IoTMakers/galena_lite_gateway_esp32/README.md

# Galena Lite Gateway

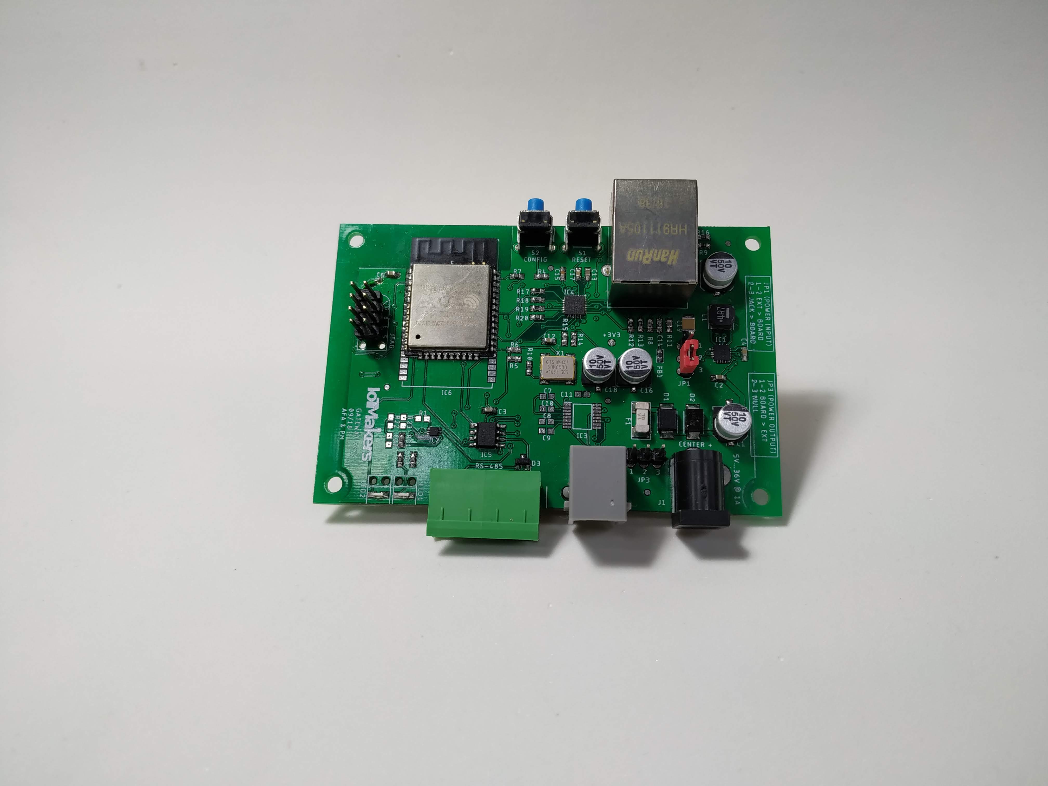
[picture p1: IMG_20190402_181117.jpg]
Galena Board


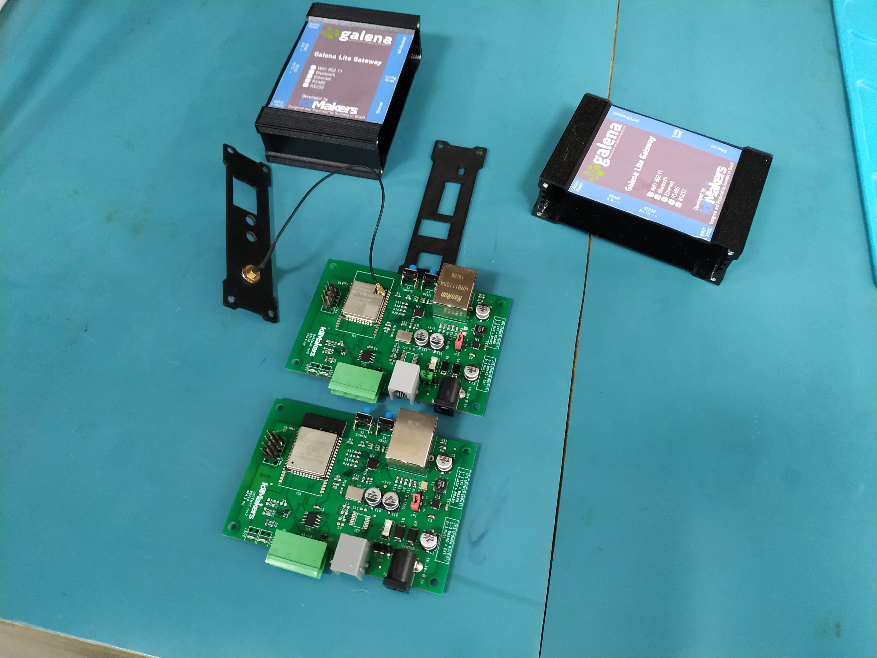
[picture p2: IMG_20190411_090804.jpg]
Galena Board 2
