IoTMakers/galena_lite_gateway_esp32/Gateway2.ods

Part | Value | PN | Package | Description
C1 | 47uFX63V | CPOL-EUUD-6,3X7,7 | UD-6,3X7,7_NICHICON | POLARIZED CAPACITOR, European symbol
C5 | 47uFX16V | CPOL-EUUD-6,3X7,7 | UD-6,3X7,7_NICHICON | POLARIZED CAPACITOR, European symbol
C2,C3,C4,C6,C7,C8,C9,C10,C11,C12,C13,C14,C17,C20 | 100nFX50V | 1.5PF-0603-50V-16.667% | 603 | 1.5pF ceramic capacitors
C15 | 10nFX50V | 1.5PF-0603-50V-16.667% | 603 | 1.5pF ceramic capacitors
C16 | 4,7uFX16V | CPOL-EUUD-6,3X7,7 | UD-6,3X7,7_NICHICON | POLARIZED CAPACITOR, European symbol
C18 | 22uFX16V | CPOL-EUUD-6,3X7,7 | UD-6,3X7,7_NICHICON | POLARIZED CAPACITOR, European symbol
C19 | 1nFx2KV | CAP1206 | 1206 | Capacitor
D1 | NRVTSS5100ET3G | DIODE-SMB | SMB | Trench Schottky Rectifier, Very Low Leakage, 100V, 5A, | https://octopart.com/nrvtss5100et3g-on+semiconductor-54318003?r=sp&s=3RSZuAp-RM25aGkVLBypew | 295 | 160 | 120
D2 | SMBJ18A | DIODE-SMB | SMB | Transient Voltage Suppressor, Tvs, Smbj Series, Unidirectional, 18 V, Do-214Aa, 2, 20 V | https://octopart.com/smbj18a-littelfuse-35303?r=sp&s=4dYVqdaxRqaxTtnNDyuJrg | 390 | 264 | 159
D3 | SM712 | CDSOT23-SM712 | SOT-23-3 | SM Series 12 V 400 W Asymmetrical TVS Diode for Extended Common-Mode - SOT-23 | https://octopart.com/sm712.tct-semtech-349737?r=sp&s=lC-qxbO_SEW0H2wgcGuGEQ | 1.47 | 1.17 | 828
F1 | FUSE_0679L | FUSE_0679L | FUSE_0679L
FB1 | KMZ1608 | SMD-FERRITE-BEAD-120R-2A(0603) | L0603 | Ferrite Beads Chip 120Ohm 25% 100MHz 500mA 150mOhm DCR 0603 Automotive T/R | https://octopart.com/kmz1608shr121atd25-tdk-81879006?r=sp&s=i-8ejY1UTXWYH8mM6MWRfQ | 86 | 78 | 58
IC1 | TS30041-M033QFNR | TS30041-M | QFN50P300X300X100-17N
IC2 | MIC826TYMT-TR | MIC826RYMT | DFN-6
IC3 | ICL3221EIVZ | ICL3221EIVZ | SOP65P640X120-16N | Intersil ICL3221EIVZ, Line Transceiver, EIA/TIA-232/ RS-232/ V.24/ V.28, 3.3 V, 5 V, 16-Pin TSSOP
IC4 | LAN8720A-CP-ABC | LAN8720A-CP-ABC | QFN50P400X400X100-25N | Small Footprint RMII 10/100 Ethernet Transceiver with flexPWR Technology | https://octopart.com/lan8720a-cp-abc-microchip-75448787?r=sp&s=7byqCG0IQSSVu6jzinN7dw | 1.03 | 837 | 837
IC5 | ISL83485 | ISL83485 | SOIC127P600X175-8N | ISL83485 Series 3.6 V 10 Mbps Surface Mount RS-485/RS-422 Transceiver - SOIC-8 | https://octopart.com/isl83485ibz-renesas-88255736?r=sp&s=jnq9nzpCSROeZyEJ8LCHPg | 1.25 | 1000 | 725
IC6 | ESP-WROOM-32 | ESP-WROOM-32 | ESP-WROOM-32 | Wifi Module 64 Mbits Spi Flash | https://octopart.com/esp-wroom-32+%288mb%29-espressif+systems-92180086?r=sp&s=xx4P1WQtRkG8gaGtFb6uUA | 4.20 | 4.20 | 4.20
J1 | POWER_JACK | POWER_JACK | POWER_JACK_PTH
J2 | RJ45-HR911105A-HR911105A | RJ45-HR911105A-HR911105A | RJ45
J3 | a | 1757268 | SHDR4W120P0X508_1X4_2224X1200X | Pluggable Terminal Blocks 4 Pos 5.08mm pitch Through Hole Header
JP1 |  | PINHD-1X3 | 1X03 | PIN HEADER
JP3 |  | PINHD-1X3 | 1X03 | PIN HEADER
K1 | RJ9 | 615004143821 | 615004143821 | WR-MJ Horizontal Plastic 4P4C Modular Jack Tab Up, 4 Pins=>Code : Con_I-O_MJ-H_Plastic_Up_615004143821
L1 | 4.7uH 2A | NRS5020T220MMGJ | INDM4949X200N | Inductor Power Shielded Wirewound 22uH 20% 100KHz Ferrite 1A 312mOhm DCR T/R
LED1,LED2 |  | LTST-S220GKT | LTST-S220KFKT | Lite-On LTST-S220GKT Green LED, 569 nm, 2012 (0805) Side View, Rectangle Lens SMD Package
R1,R6,R8,R11,R12,R13 | 49R9 | 0.27OHM-0603-1/10W-1% | 603 | 0.27Ω resistor
R2,R4,R5,R10,R15,R21,R22,R23 | 10K | 0.27OHM-0603-1/10W-1% | 603 | 0.27Ω resistor
R3,R7,R9,R16 | 330R | 0.27OHM-0603-1/10W-1% | 603 | 0.27Ω resistor
R14 | 12K1 | 0.27OHM-0603-1/10W-1% | 603 | 0.27Ω resistor
R17,R18,R19,R20 | 4K7 | 0.27OHM-0603-1/10W-1% | 603 | 0.27Ω resistor
S1,S2 | RESET | MOMENTARY-SWITCH-SPST-PTH-RIGHT-ANGLE-KIT | TACTILE_SWITCH_PTH_RIGHT_ANGLE_KIT | Momentary Switch (Pushbutton) - SPST
X1 |  | KXO-TCXO-CMOS-82 | 7.0X5.0_KXO-82-TCXO | TCXO :
