IoTMakers/galena_lite_gateway_esp32/Galena_Gateway.pdf

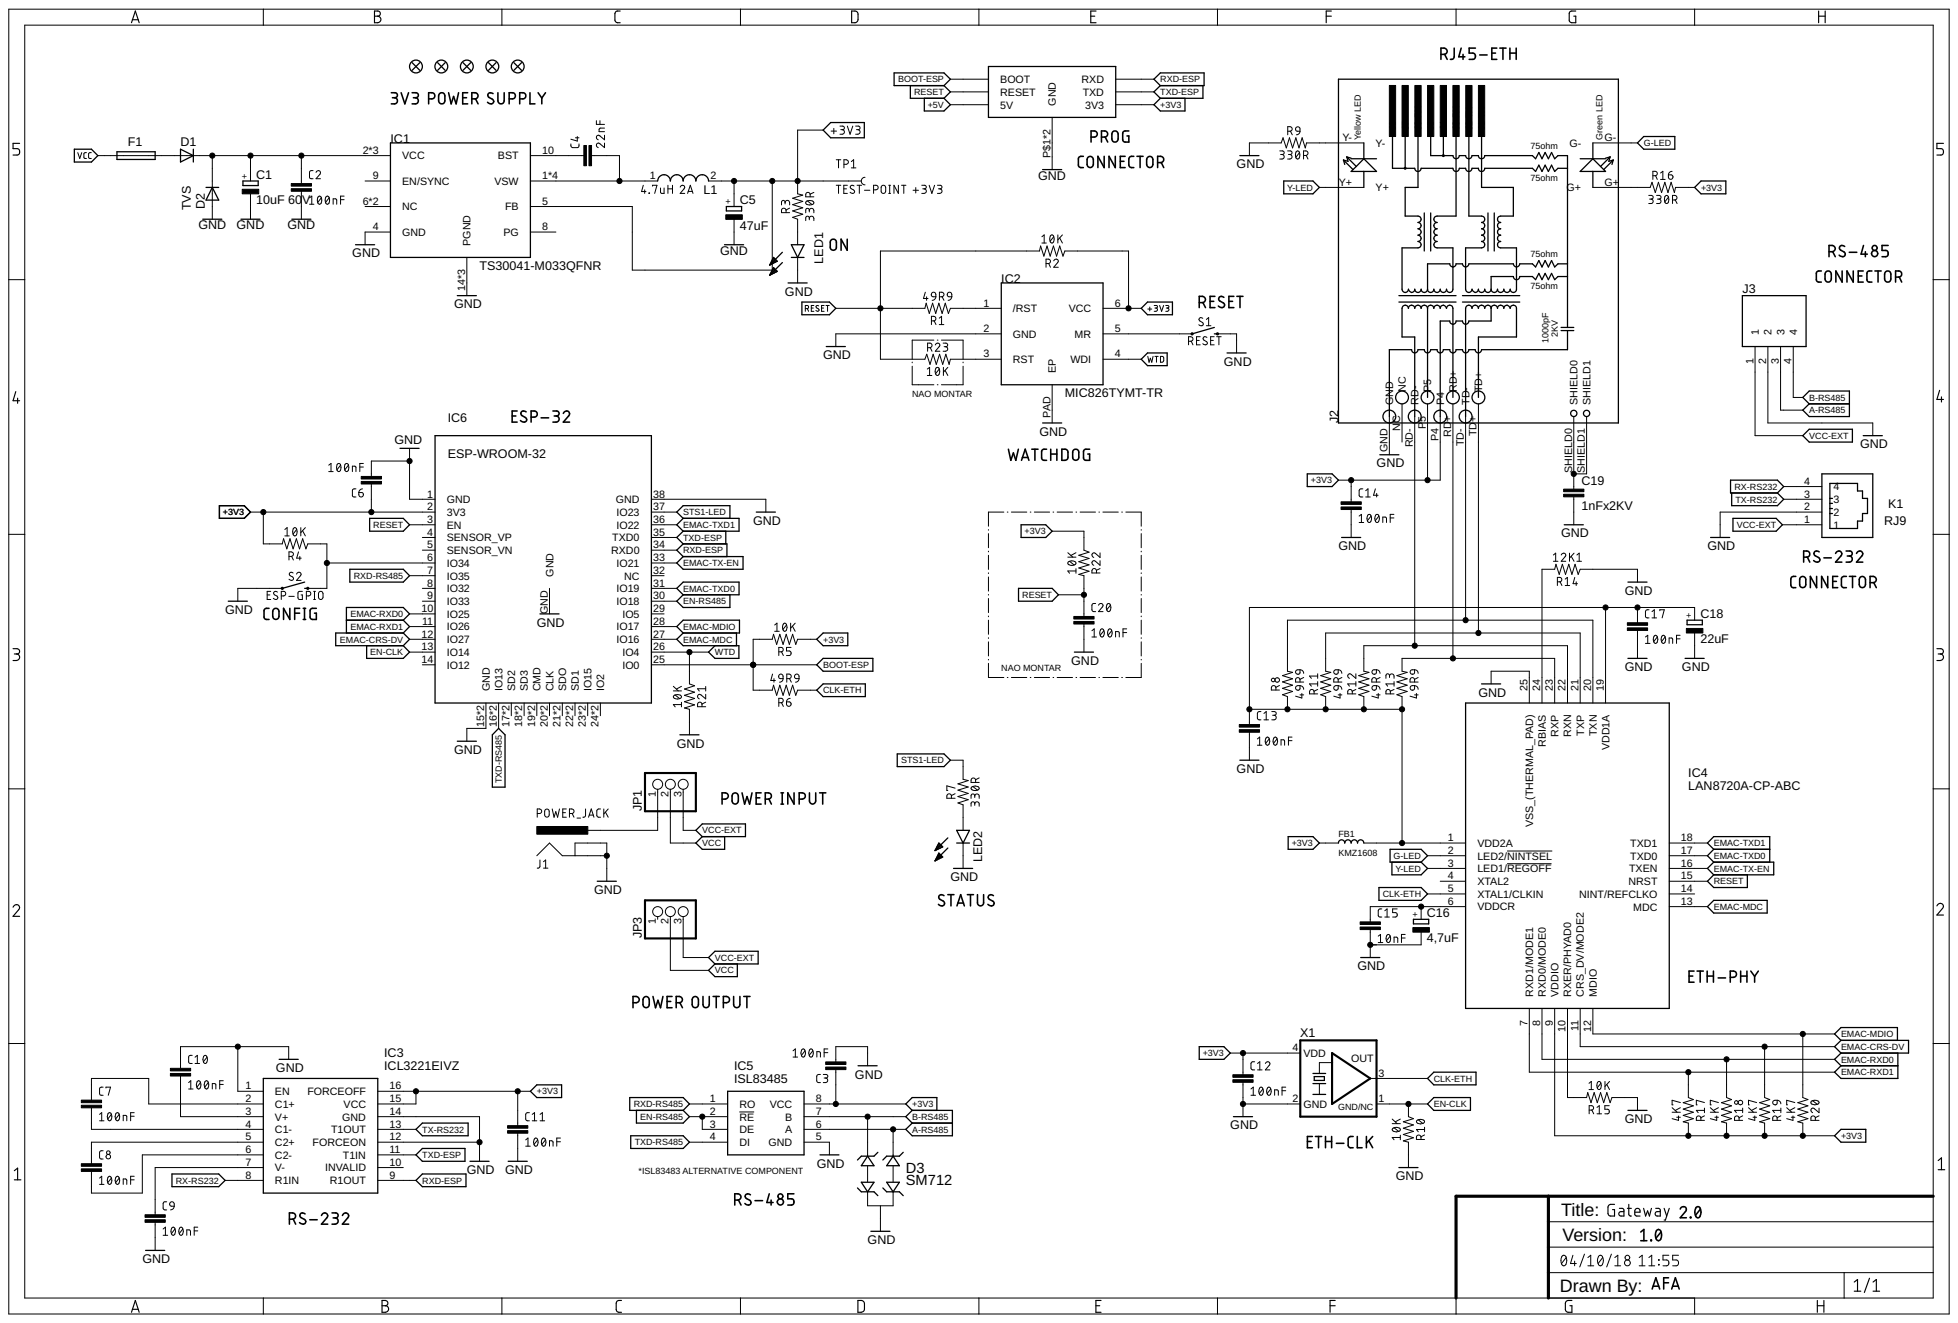
[picture p3: page 1]

J2 TX- J1 TX+ TD+ TD+ TD- TD- P4 P4 RD- RD- GND GND

7 | EMAC-TX-EN

11 EMAC-RXD1 | GND | 28 EMAC-MDIO

G-LED | LED2/NINTSEL | EMAC-TXD0 16 NRST
Y-LED | LED1/REGOFF | 15 NINT/REFCLKO EMAC-TX-EN RESET

Drawn By: Title: Version:
