IoTMakers/galena_lite_gateway_esp32/Gateway.brd

## EAGLE design Gateway.brd (2020-08-04)

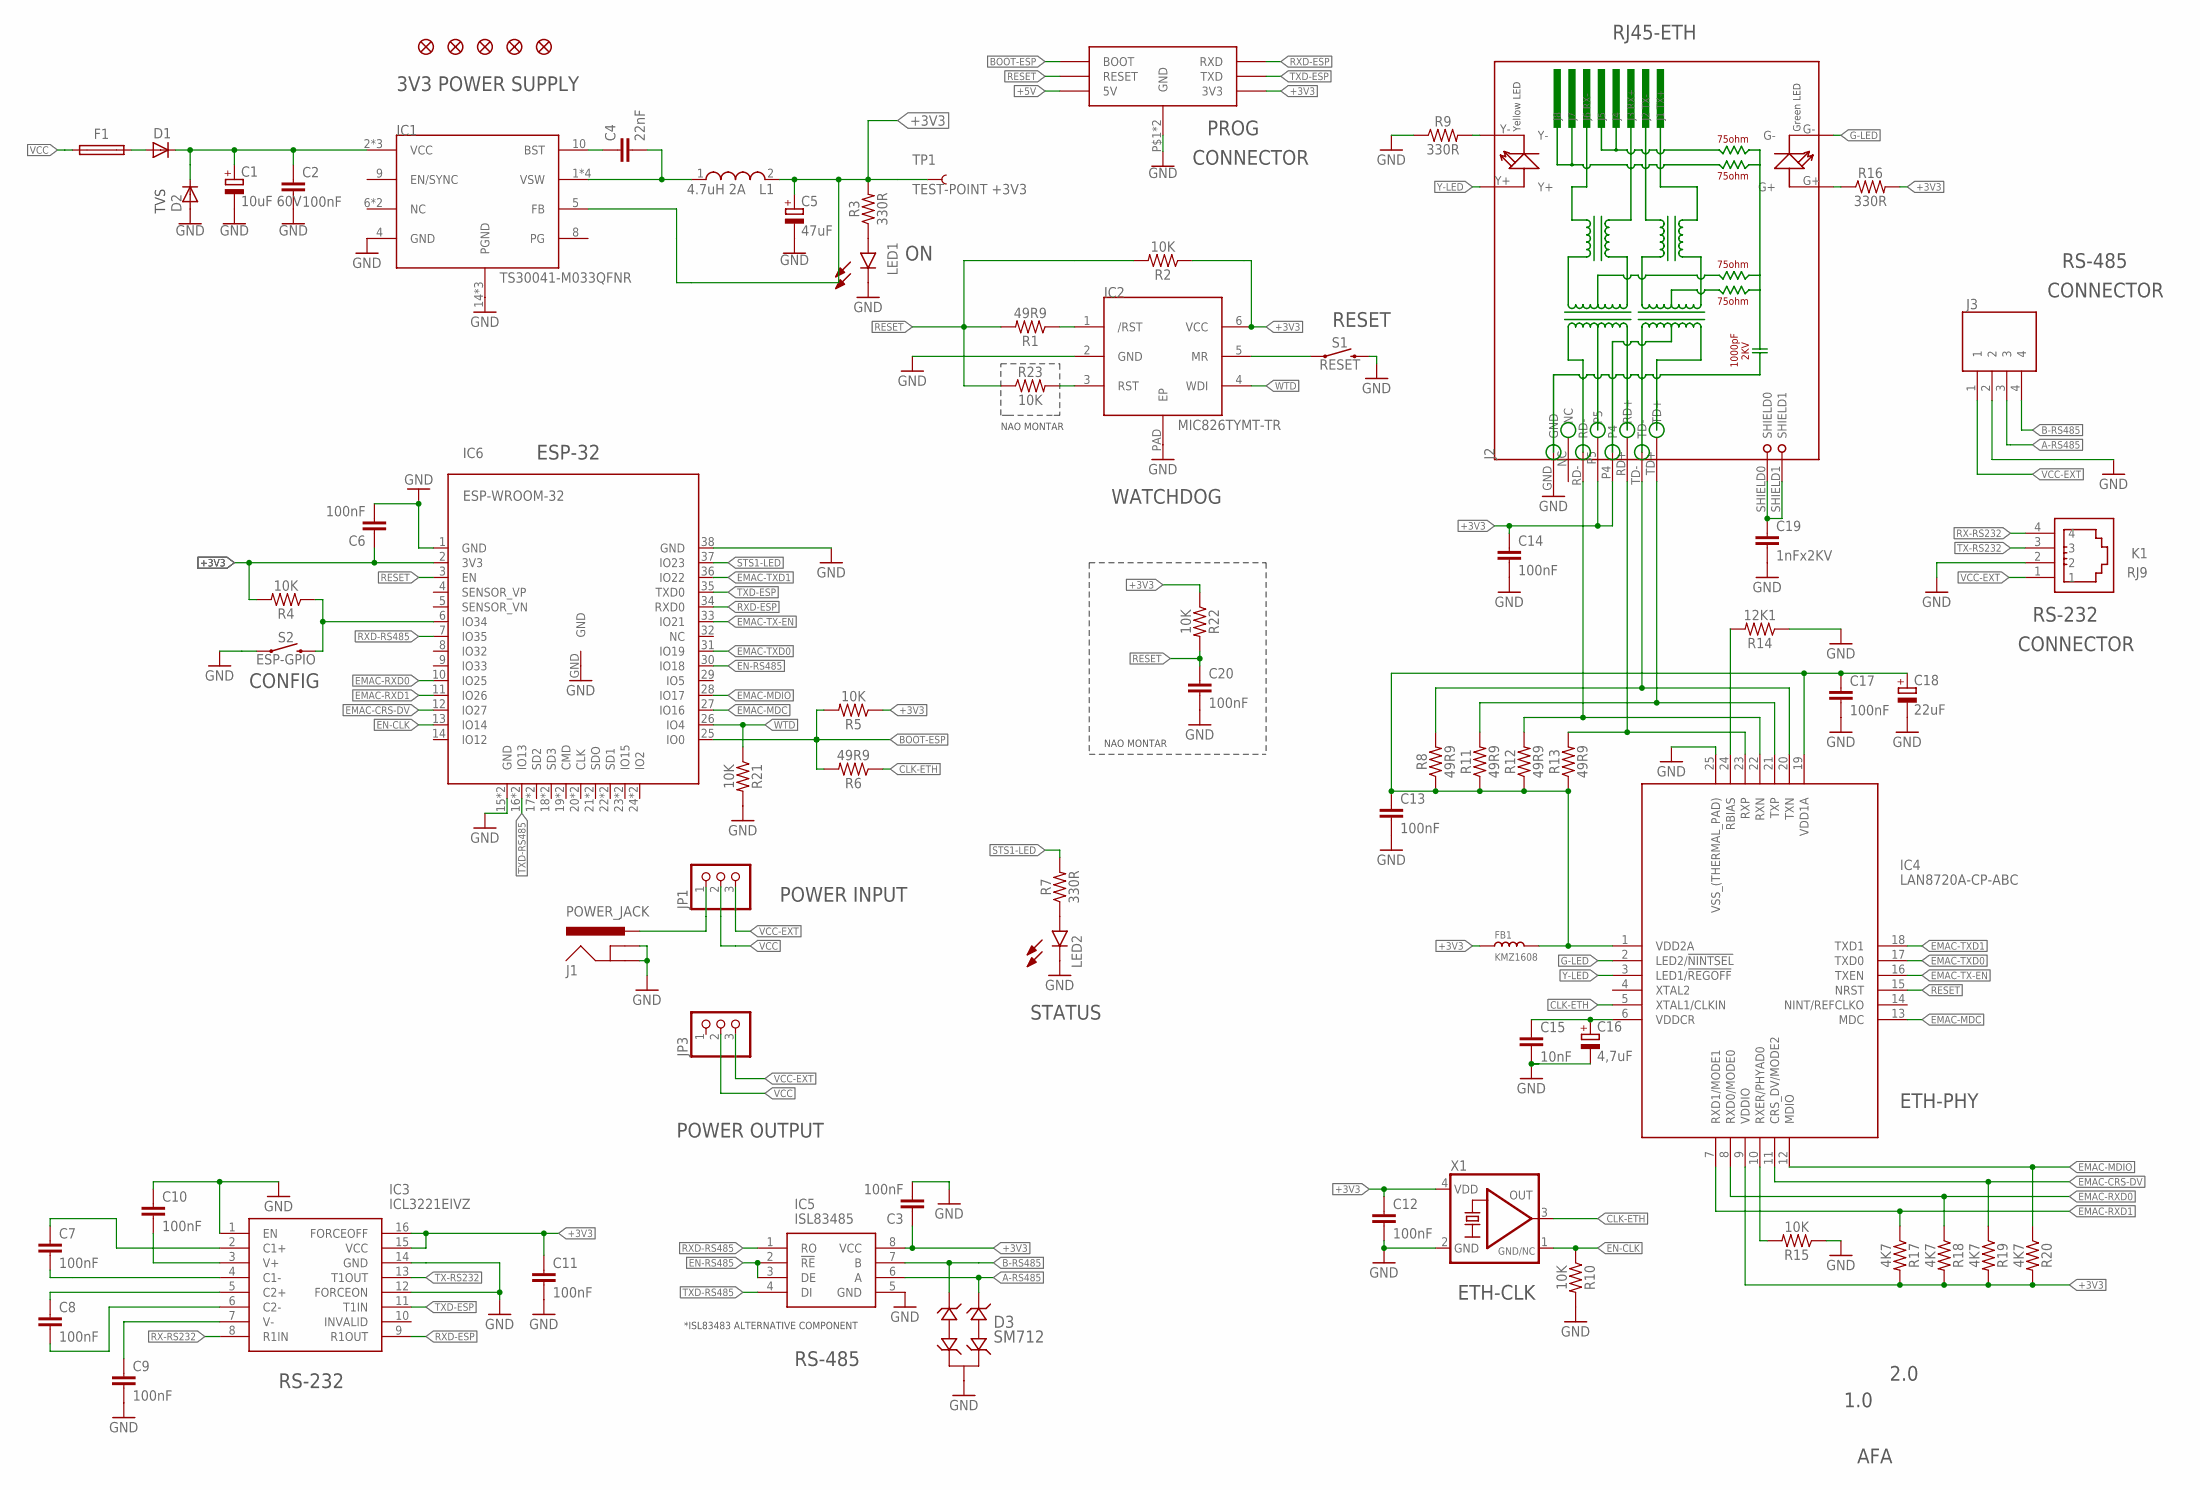
[picture p4: schematic Gateway.sch, Power Supply]

Parts:
C1: 10uF 60V; UD-6,3X7,7_NICHICON
C2, C3, C6, C7, C8, C9, C10, C11, C12, C13, C14, C17, C20: 100nF; 0603
C4: 22nF; 0603
C5: 47uF; UD-6,3X7,7_NICHICON
C15: 10nF; 0603
C16: 4,7uF; UD-6,3X7,7_NICHICON
C18: 22uF; UD-6,3X7,7_NICHICON
C19: 1nFx2KV; 1206
D1, D2: DIODE-SMB; SMB
D3: SM712; SOT-23-3
F1: FUSE_0679L
FB1: KMZ1608; L0603
FD1, FD2, FD3, FD4, FD5: FIDUCIAL1X2; FIDUCIAL-1X2
IC1: TS30041-M033QFNR; QFN50P300X300X100-17N
IC2: MIC826TYMT-TR; DFN-6
IC3: ICL3221EIVZ; SOP65P640X120-16N
IC4: LAN8720A-CP-ABC; QFN50P400X400X100-25N
IC5: ISL83485; SOIC127P600X175-8N
IC6: ESP-WROOM-32
J1: POWER_JACK; POWER_JACK_PTH
J2: RJ45-HR911105A-HR911105A; RJ45
J3: 1757268; SHDR4W120P0X508_1X4_2224X1200X
JP1, JP3: PINHD-1X3; 1X03
K1: RJ9; 615004143821
L1: 4.7uH 2A; INDM4949X200N
LED1, LED2: LTST-S220GKT; LTST-S220KFKT
R1, R6, R8, R11, R12, R13: 49R9; 0603
R2, R4, R5, R10, R15, R21, R22, R23: 10K; 0603
R3, R7, R9, R16: 330R; 0603
R14: 12K1; 0603
R17, R18, R19, R20: 4K7; 0603
S1: RESET; TACTILE_SWITCH_PTH_RIGHT_ANGLE_KIT
S2: ESP-GPIO; TACTILE_SWITCH_PTH_RIGHT_ANGLE_KIT
TP1: TEST-POINT +3V3; PAD.03X.05
U$4: ESP-PROGESPROG-4; ESPROG-4
X1: KXO-TCXO-CMOS-82; 7.0X5.0_KXO-82-TCXO

Connections:
+3V3: C3.1, C5.+, C6.1, C11.1, C12.1, C14.1, FB1.1, IC1.5 (FB), IC2.6 (VCC), IC3.15 (VCC), IC3.16 (FORCEOFF), IC4.9 (VDDIO), IC5.8 (VCC), IC6.2 (3V3), J2.P4, J2.P5, L1.2, R2.1, R3.2, R4.2, R5.1, R16.2, R17.2, R18.2, R19.2, R20.2, R22.1, TP1.P$1, U$4.3V3, X1.4 (VDD)
+5V: U$4.5V0 (5V)
A-RS485: D3.2 (IO2), IC5.6 (A), J3.3
B-RS485: D3.1 (IO1), IC5.7 (B), J3.4
BOOT-ESP: IC6.25 (IO0), R5.2, R6.2, U$4.BOOT
CLK-ETH: IC4.5 (XTAL1/CLKIN), R6.1, X1.3 (OUT)
EMAC-CRS-DV: IC4.11 (CRS_DV/MODE2), IC6.12 (IO27), R19.1
EMAC-MDC: IC4.13 (MDC), IC6.27 (IO16)
EMAC-MDIO: IC4.12 (MDIO), IC6.28 (IO17), R20.1
EMAC-RXD0: IC4.8 (RXD0/MODE0), IC6.10 (IO25), R18.1
EMAC-RXD1: IC4.7 (RXD1/MODE1), IC6.11 (IO26), R17.1
EMAC-TX-EN: IC4.16 (TXEN), IC6.33 (IO21)
EMAC-TXD0: IC4.17 (TXD0), IC6.31 (IO19)
EMAC-TXD1: IC4.18 (TXD1), IC6.36 (IO22)
EN-CLK: IC6.13 (IO14), R10.1, X1.1 (GND/NC)
EN-RS485: IC5.2 (!RE), IC5.3 (DE), IC6.30 (IO18)
G-LED: IC4.2 (LED2/!NINTSEL), J2.G-
GND: C1.-, C2.2, C3.2, C5.-, C6.2, C9.2, C10.1, C11.2, C12.2, C13.2, C14.2, C15.2, C16.-, C17.2, C18.-, C19.2, C20.2, D2.A, D3.3 (GND), IC1.4 (GND), IC1.14 (PGND), IC1.15 (PGND), IC1.17 (PGND), IC2.2 (GND), IC2.PAD (EP), IC3.1 (EN), IC3.12 (FORCEON), IC3.14 (GND), IC4.25 (VSS_(THERMAL_PAD)), IC5.5 (GND), IC6.1 (GND), IC6.15 (GND), IC6.38 (GND), IC6.39 (GND), IC6.GND, J1.GND, J1.GNDBREAK, J2.GND, J3.2, K1.2, LED1.2 (K), LED2.2 (K), R9.1, R10.2, R14.1, R15.1, R21.2, S1.2, S2.1, U$4.P$1 (GND), U$4.P$8 (GND), X1.2 (GND)
unnamed: IC2.5 (MR), S1.1
unnamed: C7.1, IC3.2 (C1+)
unnamed: C7.2, IC3.4 (C1-)
unnamed: IC6.6 (IO34), R4.1, S2.2
unnamed: C8.1, IC3.5 (C2+)
unnamed: D1.A, F1.1
unnamed: C8.2, IC3.6 (C2-)
unnamed: C10.2, IC3.3 (V+)
unnamed: C9.1, IC3.7 (V-)
unnamed: J1.PWR, JP1.1
unnamed: LED1.1 (A), R3.1
unnamed: C4.1, IC1.10 (BST)
unnamed: C13.1, C17.1, C18.+, FB1.2, IC4.1 (VDD2A), IC4.19 (VDD1A), R8.1, R11.1, R12.1, R13.1
unnamed: C19.1, J2.SHIELD0, J2.SHIELD1
unnamed: IC2.3 (RST), R23.2
unnamed: IC2.1 (/RST), R1.1
unnamed: C4.2, IC1.1 (VSW), IC1.12 (VSW), IC1.13 (VSW), IC1.16 (VSW), L1.1
unnamed: LED2.1 (A), R7.1
unnamed: J2.G+, R16.1
unnamed: IC4.23 (RXP), J2.RD+, R13.2
unnamed: IC4.22 (RXN), J2.RD-, R12.2
unnamed: IC4.21 (TXP), J2.TD+, R11.2
unnamed: J2.Y-, R9.2
unnamed: IC4.20 (TXN), J2.TD-, R8.2
unnamed: C15.1, C16.+, IC4.6 (VDDCR)
unnamed: IC4.24 (RBIAS), R14.2
unnamed: IC4.10 (RXER/PHYAD0), R15.2
POWER: C1.+, C2.1, D1.C, D2.C, IC1.2 (VCC), IC1.3 (VCC), IC1.11 (VCC)
RESET: C20.1, IC4.15 (NRST), IC6.3 (EN), R1.2, R2.2, R22.2, R23.1, U$4.RESET
RX-RS232: IC3.8 (R1IN), K1.4
RXD-ESP: IC3.9 (R1OUT), IC6.34 (RXD0), U$4.RXD
RXD-RS485: IC5.1 (RO), IC6.7 (IO35)
STS1-LED: IC6.37 (IO23), R7.2
TX-RS232: IC3.13 (T1OUT), K1.3
TXD-ESP: IC3.11 (T1IN), IC6.35 (TXD0), U$4.TXD
TXD-RS485: IC5.4 (DI), IC6.16 (IO13), IC6.40 (IO13)
VCC: F1.2, JP1.2, JP3.2
VCC-EXT: J3.1, JP1.3, JP3.3, K1.1
WTD: IC2.4 (WDI), IC6.26 (IO4), R21.1
Y-LED: IC4.3 (LED1/!REGOFF), J2.Y+

Notes on the sheet:
*ISL83483 ALTERNATIVE COMPONENT
RS-232
RS-485
STATUS
POWER OUTPUT
POWER INPUT
ESP-32
ETH-CLK
ETH-PHY
CONNECTOR
RJ45-ETH
WATCHDOG
PROG
3V3 POWER SUPPLY
2.0
1.0
AFA
NAO MONTAR
TVS
RESET
CONFIG

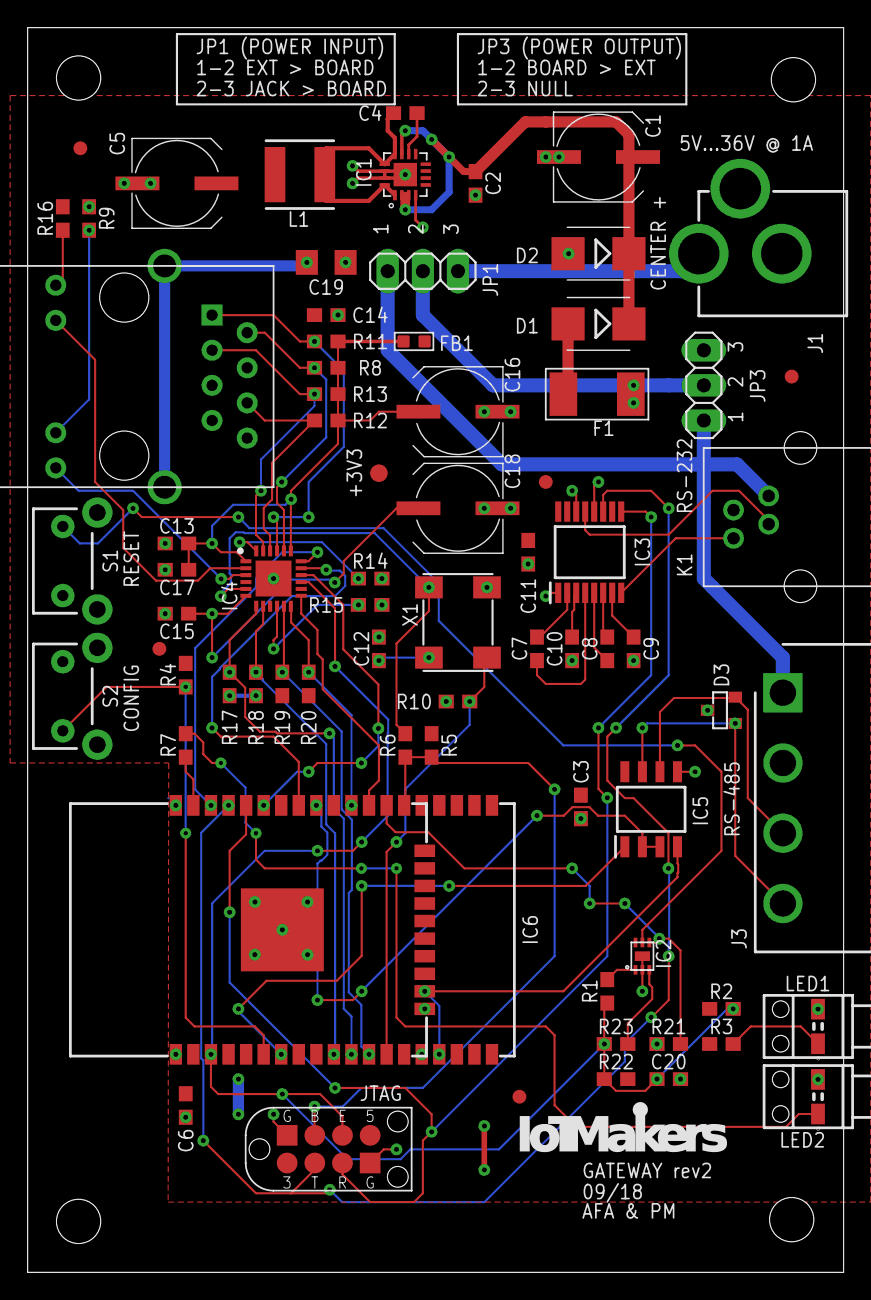
[picture p5: board Gateway.brd from above]

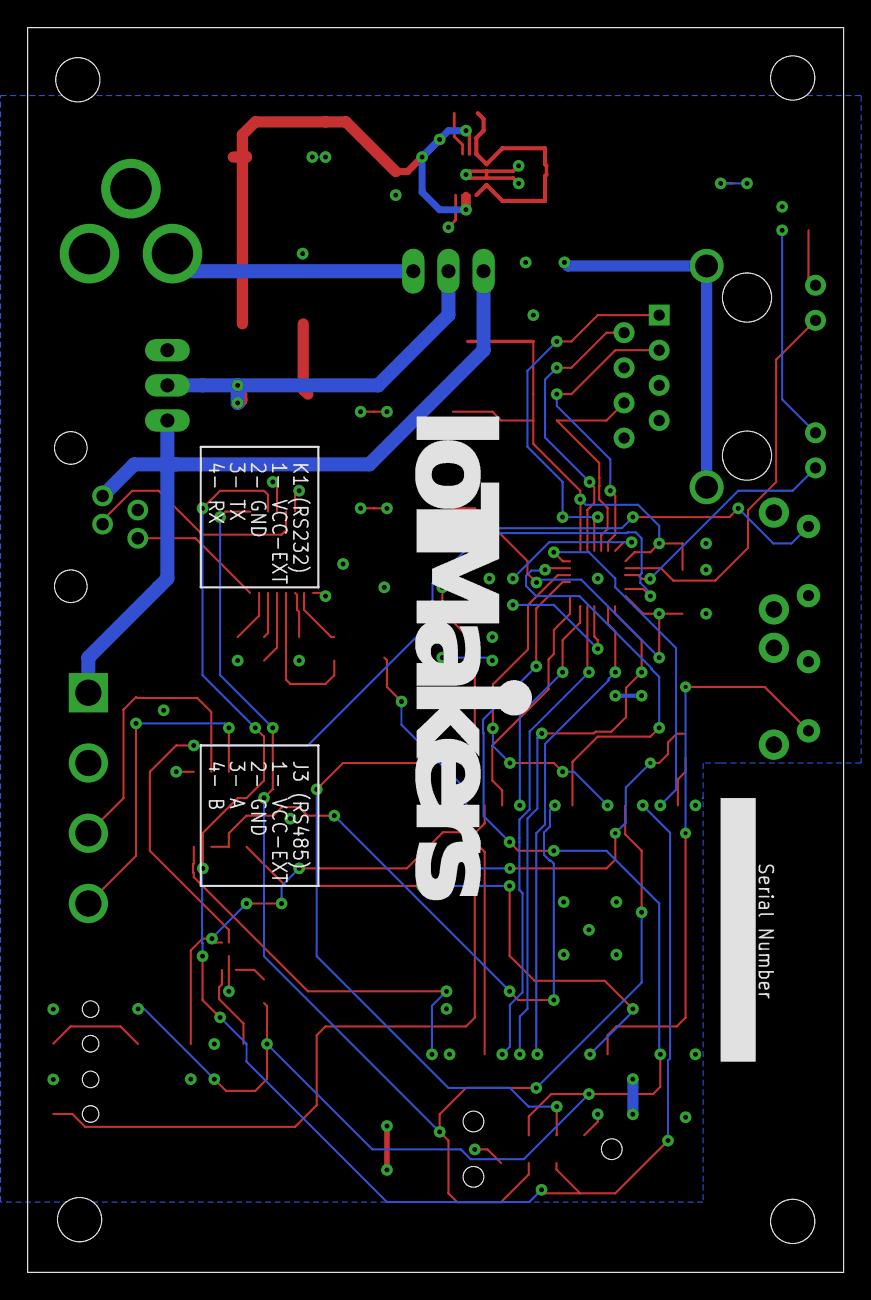
[picture p6: board Gateway.brd from below]

Board: 2 copper layers, 59.0 x 90.0 mm, 81 parts (2 on the bottom side), 57 nets.

Other parts of the board:
U$1: LOGO_L
U$2, U$6, U$8, U$9: HOLE-3.2/7.0
U$3: LOGO_XL
U$5, U$7: BIVAR_SLP3-350-100-F
