IoTMakers/galena_lite_gateway_esp32/(notices)

Notices in the files:
parts and their libraries:
SparkFun-PowerSymbols: Licensing: Creative Commons ShareAlike 4.0 International - https://creativecommons.org/licenses/by-sa/4.0
crystal-geyer_V1_0: Copyright: Geyer-Electronic
Wurth_Elektronik_Electromechanic_Input-O: Copyright: Würth Elektronik
